Rohit1050/SoC-Memory-MBIST-RISCV/doc/01_design_decisions_and_ip_specs.md

# Design Decisions and IP Specifications
## RISC-V SoC — MBIST / ECC Monitor Platform

---

## 1. Overview

This document records the architectural decisions made during RTL specification and
the IP-level register maps, parameter choices, and interface conventions that are
frozen for this project.  It is the authoritative source of truth for integration;
if it conflicts with any other document (including older PDF revisions), this file
takes precedence.

---

## 2. Global Memory Map

| Base Address | Size  | Block | Interface |
|---|---|---|---|
| `0x0004_0000` | 128 KB | ICCM | DMA Slave Port  |
| `0x0008_0000` | 128 KB | DCCM (SECDED ECC) | DMA Slave Port  |
| `0x4000_0000` | 4 KB  | **UART** | AXI4-Lite |
| `0x4000_1000` | 4 KB  | System Timer | AXI4-Lite |
| `0x4000_2000` | 4 KB  | GPIO | AXI4-Lite |
| `0x4000_3000` | 4 KB  | MBIST Controller (CSR slave) | AXI4-Lite |
| `0x4000_4000` | 4 KB  | ECC Monitor | AXI4-Lite |
| `0x4000_5000` | 4 KB  | Watchdog Timer | AXI4-Lite |

All peripherals at `0x4000_xxxx` are reached through the `axi_interconnect_wrap_4x7`
crossbar's master ports `m01`–`m06`, each via a shared AXI4-to-AXI4-Lite bridge.
The crossbar itself operates at `DATA_WIDTH=64`, `ADDR_WIDTH=32`, `ID_WIDTH=4`.
The bridge performs 64→32 data-width conversion; peripherals are 32-bit.

---

## 3. Peripheral IP Specifications

### 3.1 AXI4 Crossbar Parameters (frozen)

| Parameter | Value | Notes |
|---|---|---|
| `DATA_WIDTH` | 64 | Master-side (core IFU/LSU/Debug/MBIST) |
| `ADDR_WIDTH` | 32 | All address channels |
| `ID_WIDTH` | 4 | Applied to all slave and master ports |
| `M_REGIONS`  | 1 | Single address region per master port |

### 3.2 AXI4-Lite Peripheral Interface Convention (all IPs at `0x4000_xxxx`)

All AXI4-Lite peripherals in this project share the same port conventions,
derived from the crossbar's Lite-side port after the bridge:

| Parameter | Value | Notes |
|---|---|---|
| `DATA_WIDTH` | 32 | Bridge handles 64→32 conversion |
| `ADDR_WIDTH` | 32 | Full address bus retained through bridge |
| `ID_WIDTH` | 4 | Bridge propagates ID unchanged |

Port naming prefix: `axi_aw*`, `axi_w*`, `axi_b*`, `axi_ar*`, `axi_r*` with
`_i` / `_o` suffixes on inputs and outputs respectively.

---

### 3.3 UART — `axil_uart_top`

**File:** `rtl/UART/axil_uart_top.v`  
**Defines:** `rtl/UART/axil_uart_defines.vh`  
**Base address:** `0x4000_0000`  
**Window:** 4 KB (`0x4000_0000` – `0x4000_0FFF`)  
**Interface:** AXI4-Lite (`DATA_WIDTH=32`, `ADDR_WIDTH=32`, `ID_WIDTH=4`)

#### 3.3.1 Parameters

| Parameter | Define | Value | Frozen? |
|---|---|---|---|
| AXI data width | `_AXI_UART_DATA_WIDTH_` | 32 | ✓ |
| AXI address width | `_AXI_UART_ADDR_WIDTH_` | 32 | ✓ |
| AXI ID width | `_AXI_UART_ID_WIDTH_` | 4 | ✓ |
| Baud-rate div width | `_AXI_UART_DIV_WIDTH_` | 16 | ✓ |
| RX / TX FIFO depth | `_AXI_UART_FIFO_DEPTH_` | 16 | — |
| Default baud divisor | `_UART_BAUDRATE_DIV_INIT_` | 434 | — (115 200 bps @ 50 MHz) |
| UART data width | `_DATA_WIDTH_UART_` | 8 | ✓ |

Note: AXI4 burst parameters (`LEN_WIDTH`, `SIZE_WIDTH`, `BURST_WIDTH`,
`LOCK_WIDTH`, `CACHE_WIDTH`, `PROT_WIDTH`, `QOS_WIDTH`, `REGION_WIDTH`)
are **absent** from `axil_uart_defines.vh`.  AXI4-Lite has no burst channels.

#### 3.3.2 Register Map

All offsets are relative to the base address `0x4000_0000`.  All registers
are 32-bit wide; only the defined bits carry meaning.

| Offset  | Word idx | Register | Access | Reset  | Description |
|---|---|---|---|---|---|
| `0x000` | `5'h00`  | RBR | R | — | Receive Buffer Register.  Reads oldest RX FIFO byte.  Valid when LSR[0]=1.  If DLAB=1, reads BAUD_DIVISOR[15:0] instead. |
| `0x000` | `5'h00`  | THR | W | — | Transmit Holding Register.  Writes byte to TX FIFO.  Ignored if TX FIFO full or DLAB=1. |
| `0x004` | `5'h01`  | IER | R/W | 0x0 | Interrupt Enable Register.  IER[0]: RX data-ready interrupt enable. |
| `0x008` | `5'h02`  | BAUD_DIVISOR | R/W | 434 | Baud-rate Divisor (16-bit).  New value takes effect immediately on write.  No DLAB guard on this register's own address. |
| `0x00C` | `5'h03`  | LCR | R/W | 0x0 | Line Control Register.  See bit map below. |
| `0x010` | `5'h04`  | *(reserved)* | — | — | No register.  Reads return 0x0 with SLVERR. |
| `0x014` | `5'h05`  | LSR | R | — | Line Status Register (read-only, combinatorial).  See bit map below. |
| `0x018`+| — | *(undefined)*| — | — | All other offsets within the 4 KB window return SLVERR. |

**All offsets resolve to addresses in the range `0x4000_0000`–`0x4000_0FFF` and
are 4-byte aligned. ✓**

#### 3.3.3 LCR Bit Map (offset `0x00C`)

| Bit | Name | Reset | Description |
|-----|---|---|---|
| 0 | `STOP_BITS` | 0 | 0 = 1 stop bit; 1 = 2 stop bits |
| 1 | `PARITY_EN` | 0 | 0 = no parity; 1 = parity enabled |
| 2 | `PARITY_MODE` | 0 | 0 = odd parity; 1 = even parity |
| 6:3 | *(reserved)*  | 0 | Reads as 0; writes ignored |
| 7 | `DLAB` | 0 | Divisor Latch Access Bit.  When DLAB=1:  `0x000` R → BAUD_DIVISOR read; `0x000` W → ignored; `0x004` R/W → reserved (reads 0). |
| 31:8| *(reserved)*  | 0 | — |

#### 3.3.4 LSR Bit Map (offset `0x014`)

| Bit | Name | Description |
|-----|---|---|
| 0 | `DR` | Data Ready: 1 when RX FIFO is non-empty AND IER[0]=1 |
| 4:1 | *(reserved)*  | Always 0 |
| 5 | `THRE` | TX Holding Register Empty: 1 when TX FIFO has space  |
| 6 | `TEMT` | TX Empty: 1 when TX FIFO and TX shift register empty |
| 31:7| *(reserved)*  | Always 0 |

#### 3.3.5 Clock Domain Notes

The module has two clock inputs:

- **`fixed_clk_i`** — UART baud-clock domain.  All sequential logic, including the
  AXI4-Lite channel handshake registers, is clocked on this domain.  Must be
  ≥ 16× the desired baud rate.

- **`axi_aclk_i`** — AXI bus clock.  Present for port compatibility with the bridge
  interface.  Currently **unused internally** — the bridge-facing AXI channel
  signals are sampled directly on `fixed_clk_i`.

  **⚠ CDC hazard:** If `fixed_clk_i ≠ axi_aclk_i` the AXI input signals cross
  clock domains without synchronizers inside this module.  A future CDC pass must
  add two-flop synchronizers before deploying to an asynchronous multi-clock
  system.  The current design is correct only when the two clocks are the same
  or phase-locked.

#### 3.3.6 FIFO Behaviour

- **TX FIFO** (depth 16): firmware writes to THR; `uart_controller` drains it.
  Writes to THR when the TX FIFO is full are silently dropped.
- **RX FIFO** (depth 16): `uart_controller` pushes received bytes; reads of RBR
  pop the oldest byte.  The `DR` bit in LSR reflects non-empty status gated by
  `IER[0]`.  If the FIFO overflows, the oldest unread byte is overwritten (no
  overflow interrupt in this revision).

#### 3.3.7 Decision: 16550-style map vs. 4-register placeholder

The `axi4_uart_top.v` baseline carried a 16550-compatible register map
(RBR/THR, IER, BAUD_DIVISOR, LCR, LSR).  An earlier design-document draft
contained a simpler 4-register placeholder.  **Decision: the 16550-style map
is adopted as the project's frozen UART register map** because:

1. It is already implemented by the UART datapath sub-modules
   (`uart_controller`, `uart_transmitter`, `uart_receiver`).
2. It provides interrupt enable, configurable parity/stop-bits, and baud-rate
   control — all required by the firmware self-test loop.
3. The DLAB mechanism allows baud-rate divisor access without consuming an
   additional register offset.

The simpler placeholder is superseded by this table.

---

### 3.4 Watchdog Timer — `axil_wdt_top`

**File:** `rtl/watchdog_timer/axil_wdt_top.v`  
**Base address:** `0x4000_5000`  
**Window:** 4 KB (`0x4000_5000` – `0x4000_5FFF`)  
**Crossbar port:** `m06` on `axi_interconnect_wrap_4x7` (via AXI4-to-AXI4-Lite bridge)  
**Interface:** AXI4-Lite (`DATA_WIDTH=32`, `ADDR_WIDTH=32`, `ID_WIDTH=4`)  

#### 3.4.1 Register Map

All offsets are relative to base address `0x4000_5000`. All registers are 32-bit aligned.

| Offset  | Word idx | Register | Access | Reset | Description |
|---|---|---|---|---|---|
| `0x000` | `4'h0` | `wdg_enable` | R/W | 0x0 | Master enable. Bit 0 enables the countdown. |
| `0x004` | `4'h1` | `wdg_load` | R/W | 0x0 | Timeout and reload value in clock cycles. |
| `0x008` | `4'h2` | `wdg_kick` | W | — | Pet watchdog. Writing any value reloads `wdg_count` with `wdg_load`. Reads return 0. |
| `0x00C` | `4'h3` | `wdg_count` | RO | 0x0 | Current countdown value (diagnostic read). Writes return SLVERR. |
| `0x010` | `4'h4` | `wdg_status` | R/W1C  | 0x0 | Bit 0: `timeout_occurred` — latched across warm reset; write 1 to clear. |
| `0x014` | `4'h5` | `wdg_pretimeout`  | R/W | 0x0 | Early-warning threshold; asserts `wdg_irq_pretimeout` when count <= val. |
| `0x018`+| — | *(undefined)* | — | — | All other offsets within the 4 KB window return SLVERR. |

#### 3.4.2 Non-Bus Signals

| Signal | Direction | Width | Destination | Description |
|---|---|---|---|---|
| `wdg_timeout_o` | Output | 1 | External Reset Logic  | Asserted on countdown expiry; drives system reset via `rst_l`. |
| `wdg_irq_pretimeout_o` | Output | 1 | PIC (`extintsrc_req`) | Early-warning interrupt prior to timeout expiry. |
| `timeout_occurred_o` | Output | 1 | Debug / Diagnostics | Direct status tap of `timeout_occurred` flag. |

#### 3.4.3 Reset and Post-Mortem Architecture

The Watchdog Timer uses a dual-reset architecture:
- **`por_rstn_i`** (Power-On Reset / Cold Reset): Resets the sticky `timeout_occurred` status bit to 0.
- **`axi_aresetn_i`** (System / Warm Reset): Resets the FSMs, `wdg_enable`, `wdg_load`, and `wdg_count`. The `timeout_occurred` flag is intentionally preserved across `axi_aresetn_i` assertions. When `wdg_timeout_o` triggers external reset logic, the core reboots, firmware reads `wdg_status[0] == 1`, identifies a watchdog recovery event, and writes 1 to clear the status bit (W1C).

---

### 3.5 ECC Monitor — `axil_ecc_monitor_top`

**File:** `rtl/ecc_monitor/axil_ecc_monitor_top.v`  
**Base address:** `0x4000_4000`  
**Window:** 4 KB (`0x4000_4000` – `0x4000_4FFF`)  
**Crossbar port:** `m05` on `axi_interconnect_wrap_4x7` (via AXI4-to-AXI4-Lite bridge)  
**Interface:** AXI4-Lite (`DATA_WIDTH=32`, `ADDR_WIDTH=32`, `ID_WIDTH=4`)  

#### 3.5.1 Register Map

| Offset  | Word idx | Register | Access | Reset | Description |
|---|---|---|---|---|---|
| `0x000` | `3'h0` | `ecc_mon_enable` | R/W | 0x0 | Master enable bit. |
| `0x004` | `3'h1` | `ecc_mon_shadow_count`  | R/W | 0x0 | 27-bit firmware mirror of core CSR `mdccmect.count`. |
| `0x008` | `3'h2` | `ecc_mon_shadow_thresh` | R/W | 0x0 | 5-bit firmware mirror of core CSR `mdccmect.thresh`. |
| `0x00C` | `3'h3` | `ecc_mon_event` | W1C | 0x0 | FW writes 1 to signal correctable ISR fired; triggers correlation. |
| `0x010` | `3'h4` | `ecc_mon_suspect_addr`  | RO | 0x0 | MBIST window active at last correlated event. |
| `0x014` | `3'h5` | `ecc_mon_status` | RO | 0x0 | Bit 0: `correctable_seen`; Bit 1: `mbist_correlated`. |
| `0x018`+| — | *(undefined)* | — | — | All other offsets in 4 KB window return SLVERR. |

---

### 3.6 MBIST Controller — `axil_mbist_ctrl_top`

**Files:** `rtl/mbist_controller/axil_mbist_ctrl_top.v`, `mbist_algo_engine.v`, `mbist_dma_master.v`, `axil_mbist_defines.vh`  
**Base address:** `0x4000_3000`  
**Window:** 4 KB (`0x4000_3000` – `0x4000_3FFF`)  
**Crossbar ports:** Slave CSR `m04` (AXI4-Lite via bridge); Master DMA port `s03` (64-bit full AXI4 to DCCM)  
**Interface:** Dual-personality: 32-bit AXI4-Lite slave + 64-bit AXI4 master  

#### 3.6.1 Register Map

| Offset  | Word idx | Register | Access | Reset | Description |
|---|---|---|---|---|---|
| `0x000` | `4'h0` | `mbist_start` | W | — | Write 1 to launch self-test scan (auto-clears). |
| `0x004` | `4'h1` | `mbist_algo_sel` | R/W | `2'b01` | 00 = Checkerboard, 01 = March C-. |
| `0x008` | `4'h2` | `mbist_addr_start`  | R/W | `0x00080000` | Start address of DCCM test region (64-bit aligned). |
| `0x00C` | `4'h3` | `mbist_addr_end` | R/W | `0x0009FFF8` | End address of DCCM test region (64-bit aligned). |
| `0x010` | `4'h4` | `mbist_busy` | RO | 0x0 | Asserted while self-test is actively executing. |
| `0x014` | `4'h5` | `mbist_done` | RO/W1C | 0x0 | Asserted on scan completion; cleared on new start or writing 1. |
| `0x018` | `4'h6` | `mbist_pass_fail` | RO | 0x0 | 0 = PASS, 1 = Directly-detected fault present (SLVERR or data mismatch).|
| `0x01C` | `4'h7` | `mbist_fault_addr`  | RO | 0x0 | Address of the first directly-detected fault. |
| `0x020` | `4'h8` | `mbist_fault_count` | RO | 0x0 | 16-bit count of directly-detected faults. |
| `0x024`+| — | *(undefined)* | — | — | All other offsets in 4 KB window return SLVERR. |

#### 3.6.2 Sideband Signals

| Signal | Direction | Width | Destination | Description |
|---|---|---|---|---|
| `mbist_active_o` | Output | 1 | ECC Monitor, WDT | Asserted during active scan for ECC correlation. |
| `mbist_fault_addr_tap_o` | Output | 32 | ECC Monitor | Real-time test window tap latched upon correctable error.|
| `mbist_irq_done_o` | Output | 1 | PIC (`extintsrc_req`)  | 1-cycle interrupt pulse on scan completion. |
| `timer_tick_i` | Input | 1 | System Timer | External auto-trigger pulse to start scan. |

---

## 4. Verification Notes

- **UART:** `tb/uart/tb_axil_uart_top.v` (10 test cases)
- **ECC Monitor:** `tb/ecc_monitor/tb_axil_ecc_monitor_top.v` (15 test cases)
- **Watchdog Timer:** `tb/watchdog_timer/tb_axil_wdt_top.v` (12 test cases)
- **MBIST Controller:** `tb/mbist_controller/tb_axil_mbist_ctrl_top.v` (9 test cases)
- Shared AXI4-Lite BFM master: `tb/common/axil_bfm_master.v`

---

*Document revision: 1.2 — 2026-10-02*
