Rohit1050/SoC-Memory-MBIST-RISCV/rtl/interconnect/soc_register_map_across_crossbar.png

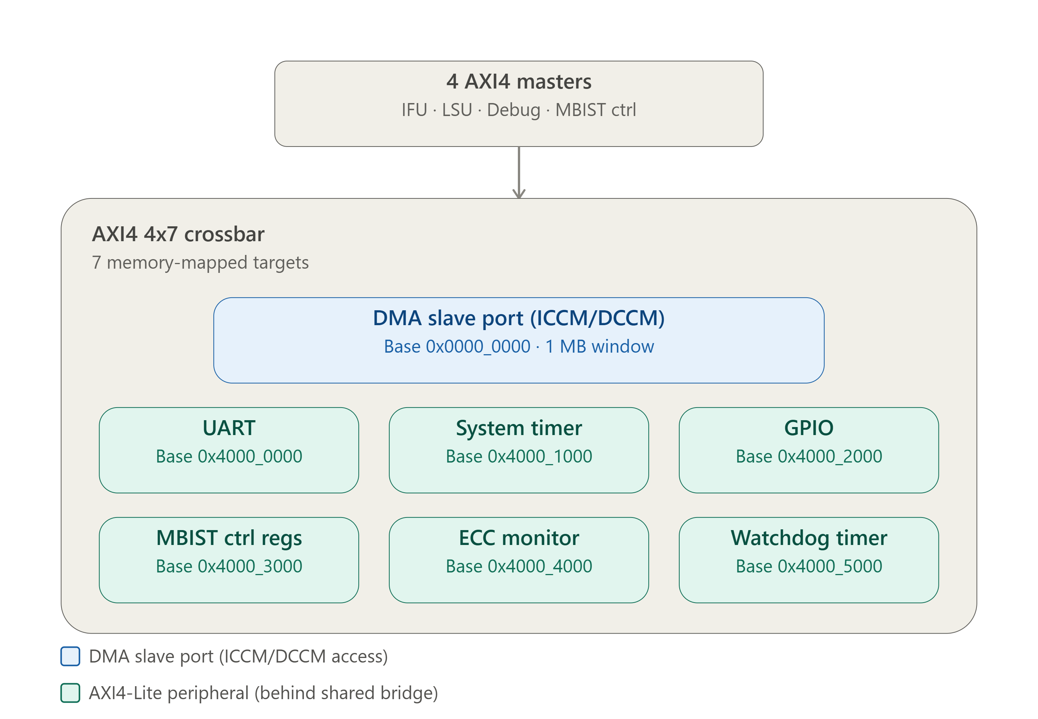
rtl/interconnect/soc_register_map_across_crossbar.png
