Rohit1050/SoC-Memory-MBIST-RISCV/doc/testmap_soc_readable.xlsx

Sheet: Testmap_SoC_Categorized
S.No | Test Name | Test Scope | Description | C Portion (firmware/test/) | SV Portion (tb/) | Interface
1 | BOOT_RESET_VECTOR | External to SoC | Core fetches first instruction from ICCM base 0x0004_0000 after reset release — confirms rst_vec wiring in soc_core_integration.sv | Not applicable | tb_soc_top.sv — TC01: monitor no ECC double-error and no UART FAIL within 500 cycles after reset release
2 | BOOT_ICCM_LOAD | External to SoC | Firmware loaded into ICCM via $readmemh before reset release; core executes correct code from cycle 1 | Not applicable | tb_soc_top.sv — runtime $readmemh into u_iccm.flat_image + ECC recompute in reset initial block
3 | BOOT_STACK_INIT | Internal to SoC | crt0.s sets SP to DCCM top (0x0008_4000); .data copied from ICCM LMA to DCCM VMA; .bss zeroed before main() | Implicit in every test — if stack is wrong all tests fail | iccm_behavioral_model.v — verifies flat_image bank interleave and ECC matches
4 | BOOT_NO_SPURIOUS_ECC | External to SoC | No ECC single or double errors asserted in first 500 cycles on a freshly-loaded clean ICCM/DCCM | Not applicable | tb_soc_top.sv — monitor dccm_ecc_single_error / dccm_ecc_double_error / iccm_ecc_single_error / iccm_ecc_double_error
5 | XBAR_ADDR_DECODE_UART | Internal to SoC | LSU write to 0x4000_0000 routes to m01 (UART) with OKAY response — confirms crossbar address decode | test_uart.c — any UART_THR write exercises this path | tb_soc_top.sv — monitor m01_axi_awvalid + m01_axi_awaddr == 0x4000_0000
6 | XBAR_ADDR_DECODE_TIMER | Internal to SoC | LSU access to 0x4000_1000 routes to m02 (System Timer) | test_timer.c — TMR_EN write | tb_soc_top.sv — monitor m02_axi_awvalid + m02_axi_awaddr == 0x4000_1000
7 | XBAR_ADDR_DECODE_GPIO | Internal to SoC | LSU access to 0x4000_2000 routes to m03 (GPIO) | test_gpio.c — GPIO_DIR write | tb_soc_top.sv — TC02: monitor m03_axi_arvalid handshake
8 | XBAR_ADDR_DECODE_MBIST | Internal to SoC | LSU access to 0x4000_3000 routes to m04 (MBIST CSR) | test_mbist.c — MBIST_START write | tb_soc_top.sv — monitor m04_axi_awaddr == 0x4000_3000
9 | XBAR_ADDR_DECODE_ECC | Internal to SoC | LSU access to 0x4000_4000 routes to m05 (ECC Monitor) | test_ecc.c — ECC_ENABLE write | tb_soc_top.sv — monitor m05_axi_awvalid
10 | XBAR_ADDR_DECODE_WDT | Internal to SoC | LSU access to 0x4000_5000 routes to m06 (WDT) | test_watchdog.c — WDG_ENABLE write | tb_soc_top.sv — monitor m06_axi_awvalid
11 | XBAR_DECERR_UNMAPPED | Internal to SoC | LSU access to unmapped address (e.g. 0xDEAD_0000) returns DECERR from crossbar — core must survive | Implicit — firmware accesses unmapped offset in SLVERR subtests | tb_soc_top.sv — TC02: monitor any mXX_rresp == 2b11 (DECERR)
12 | XBAR_64TO32_BRIDGE | Internal to SoC | AXI4 64-bit LSU write correctly downconverted to 32-bit by axi4_to_axil_bridge before reaching peripheral register | test_gpio.c — GPIO_OUT = 0xA5 (32-bit value visible on 64-bit bus) | tb_axil_gpio_top.v — verify wdata[31:0] matches written value after bridge
13 | XBAR_CONCURRENT_MASTERS | Internal to SoC | IFU fetch (m00/ICCM) and LSU peripheral write (m01-m06) occur simultaneously without arbitration deadlock | Any firmware test — IFU always active while LSU writes | tb_soc_top.sv — monitor ifu_axi_arvalid and lsu_axi_awvalid high in same cycle
14 | UART_RESET_STATE | Internal to SoC | LSR[5] THRE=1 and LSR[6] TEMT=1 at cold boot (TX FIFO and shift register empty) | test_uart.c — Subtest 1: read LSR at boot | tb_axil_uart_top.v — check LSR reset value
15 | UART_LCR_8N1 | Internal to SoC | LCR=0x03 programs 8 data bits / no parity / 1 stop bit; readback matches | test_uart.c — Subtest 2: write 0x03 read back | tb_axil_uart_top.v — verify LCR register stores value
16 | UART_LCR_PARITY | External to SoC | LCR parity bits (odd/even) write and readback correctly | test_uart.c — Subtest 2: 0x0B (8O1) / 0x1B (8E1) | tb_axil_uart_top.v — verify parity encoding on TX serial output | UART serial
17 | UART_BAUD_DLAB | Internal to SoC | LCR[7]=1 enables DLAB; BAUD_DIV register write/readback at 0x4000_0008 | test_uart.c — Subtest 3: LCR=0x83 then write/read UART_BDIV | tb_axil_uart_top.v — verify baud divisor register path
18 | UART_TX_THRE_POLL | External to SoC | Firmware writes THR only when LSR[5]=1 (THRE); no data loss under polling | test_uart.c — Subtest 5: send A-Z with explicit THRE poll | tb_axil_uart_top.v — verify each byte appears on uart_tx_o serial output | UART serial
19 | UART_TX_FIFO_DEPTH | Internal to SoC | TX FIFO holds 16 entries; firmware can burst 16 bytes without THRE stalling | test_uart.c — Subtest 6: three-line burst | tb_axil_uart_top.v — verify no byte dropped during burst
20 | UART_TEMT_DRAIN | External to SoC | LSR[6] TEMT asserts only after both TX FIFO and TX shift register drain | test_uart.c — Subtest 7: wait_temt() after burst | tb_axil_uart_top.v — monitor TEMT high after last serial bit | UART serial
21 | UART_IER_RW | Internal to SoC | IER bits 0 and 1 write/readback independently; clear to 0 disables all interrupts | test_uart.c — Subtest 4: IER=0x01 / 0x02 / 0x03 / 0x00 | tb_axil_uart_top.v — verify IER register behaviour
22 | UART_SLVERR_UNMAPPED | Internal to SoC | Read from UART+0x010 (reserved offset) returns SLVERR; CPU continues executing | test_uart.c — Subtest 8: read from UART_BASE+0x010 | tb_axil_uart_top.v — verify SLVERR response on unmapped offset
23 | GPIO_RESET_STATE | Internal to SoC | GPIO_DIR=0x00 (all inputs) and GPIO_OUT=0x00 after reset | test_gpio.c — Subtest 1: read DIR and OUT at boot | tb_axil_gpio_top.v — verify reset values of both registers
24 | GPIO_DIR_WALKING_ONES | External to SoC | Each individual GPIO_DIR bit can be set to 1 independently (8 iterations) | test_gpio.c — Subtest 2: walking-ones loop | tb_axil_gpio_top.v — verify gpio_out_o gating per bit | GPIO output
25 | GPIO_DIR_WALKING_ZEROS | External to SoC | Each individual GPIO_DIR bit can be cleared to 0 independently | test_gpio.c — Subtest 2: walking-zeros loop | tb_axil_gpio_top.v — verify gpio_out_o gating per bit | GPIO output
26 | GPIO_OUT_CHECKERBOARD | External to SoC | GPIO_OUT=0xA5 and GPIO_OUT=0x5A write/readback correctly | test_gpio.c — Subtest 3: 0xA5 / 0x5A patterns | tb_axil_gpio_top.v — verify gpio_out_o == DIR & OUT | GPIO output
27 | GPIO_OUT_DIR_INDEPENDENCE | Internal to SoC | GPIO_OUT retains value across GPIO_DIR changes (DIR does not corrupt OUT register) | test_gpio.c — Subtest 4: set OUT=0xC3 then flip DIR multiple times | tb_axil_gpio_top.v — verify gpio_out_o changes but OUT register constant
28 | GPIO_IN_READONLY | Internal to SoC | Writes to GPIO_IN offset are silently ignored; register value unchanged | test_gpio.c — Subtest 5: write ~before to GPIO_IN; readback unchanged | tb_axil_gpio_top.v — force gpio_in_i; verify write to 0x008 has no effect
29 | GPIO_OUTPUT_GATING | External to SoC | gpio_out_o[i] = gpio_dir[i] AND gpio_out_reg[i] — hardware gating verified | test_gpio.c — Subtest 6: DIR=0x0F OUT=0xFF; expected gpio_out_o=0x0F | tb_axil_gpio_top.v — check gpio_out_o against expected mask | GPIO output
30 | GPIO_INPUT_SYNC | External to SoC | gpio_in_i external value appears in GPIO_IN after 2-flop synchronisation | Not applicable (requires TB to drive gpio_in_i) | tb_axil_gpio_top.v — force gpio_in_i; read GPIO_IN after 2 clock edges | GPIO input
31 | GPIO_SLVERR_UNMAPPED | Internal to SoC | Read from GPIO+0x00C (unmapped) returns SLVERR; CPU survives | test_gpio.c — Subtest 7: read from GPIO_BASE+0x00C | tb_axil_gpio_top.v — verify SLVERR on unmapped GPIO offset
32 | TIMER_RESET_STATE | Internal to SoC | TMR_EN=0 / TMR_RELOAD=0 / TMR_COUNT=0 at cold boot | test_timer.c — Subtest 1: read all three registers at boot | tb_axil_systimer_top.v — verify reset values
33 | TIMER_RELOAD_RW | Internal to SoC | TMR_RELOAD accepts full 32-bit values including 0xDEADBEEF and 0xFFFFFFFF | test_timer.c — Subtest 2: multiple reload values | tb_axil_systimer_top.v — verify register storage
34 | TIMER_COUNTDOWN | Internal to SoC | TMR_COUNT decrements every clock cycle while TMR_EN=1; two reads show strictly decreasing value | test_timer.c — Subtest 3: c1 then delay then c2; assert c2 < c1 | tb_axil_systimer_top.v — monitor timer_count decrement
35 | TIMER_HOLD_ON_DISABLE | Internal to SoC | TMR_COUNT freezes (holds) when TMR_EN=0; re-enable resumes from frozen value | test_timer.c — Subtest 4: read h1/h2 while disabled; assert h1==h2 | tb_axil_systimer_top.v — verify count stops on disable
36 | TIMER_REARM | Internal to SoC | Disable then write TMR_RELOAD then re-enable: count preloads to TMR_RELOAD value (not frozen value) | test_timer.c — Subtest 5: partially drain; re-arm with new_reload; verify count==new_reload | tb_axil_systimer_top.v — verify re-arm preloads reload value
37 | TIMER_COUNT_READONLY | Internal to SoC | Writes to TMR_COUNT (0x008) are silently accepted (OKAY) but counter is unaffected | test_timer.c — Subtest 6: write 0xDEADBEEF to TMR_COUNT; readback unchanged | tb_axil_systimer_top.v — verify write to RO register has no effect
38 | TIMER_TICK_PULSE | Internal to SoC | timer_tick_o pulses HIGH for exactly 1 clock cycle on countdown expiry; counter auto-reloads | Not applicable (requires cycle-accurate measurement) | tb_axil_systimer_top.v — monitor timer_tick_o width == 1 cycle
39 | TIMER_TICK_MBIST_TRIGGER | Internal to SoC | timer_tick_o connected to MBIST Controller timer_tick_i; MBIST auto-starts on tick | Not applicable (SoC-level wiring) | tb_soc_top.sv — TC07: pulse timer_tick; verify mbist_active asserts within 20 cycles
40 | TIMER_SLVERR_UNMAPPED | Internal to SoC | Read from Timer+0x00C (unmapped) returns SLVERR; CPU survives | test_timer.c — Subtest 8: read from TMR_BASE+0x00C | tb_axil_systimer_top.v — verify SLVERR response
41 | WDT_RESET_STATE | Internal to SoC | WDG_ENABLE=0 at cold boot; WDT not running; no spurious timeout | test_watchdog.c — Subtest 1: read WDG_ENABLE at boot | tb_axil_wdt_top.v — verify no wdg_timeout_o pulse at reset
42 | WDT_LOAD_RW | Internal to SoC | WDG_LOAD accepts full 32-bit values including boundary cases | test_watchdog.c — Subtest 2: multiple load values | tb_axil_wdt_top.v — verify register storage
43 | WDT_COUNTDOWN | Internal to SoC | WDG_COUNT decrements each clock cycle while WDG_ENABLE=1 | test_watchdog.c — Subtest 3: enable; read c1/c2; assert c2 < c1 | tb_axil_wdt_top.v — monitor wdg_count decrement
44 | WDT_KICK_RELOADS | Internal to SoC | Writing WDG_KICK reloads WDG_COUNT to WDG_LOAD instantly | test_watchdog.c — Subtest 4: enable; drain; kick; assert count==WDG_LOAD | tb_axil_wdt_top.v — verify count restores to load value on kick
45 | WDT_HOLD_ON_DISABLE | Internal to SoC | WDG_COUNT holds at current value when WDG_ENABLE=0 (does NOT reset to load) | test_watchdog.c — Subtest 5: disable; read h1/h2; assert h1==h2 and h1!=WDG_LOAD | tb_axil_wdt_top.v — verify count freezes on disable
46 | WDT_STATUS_W1C | Internal to SoC | WDG_STATUS[0] timeout_occurred cleared by writing 1; writing 0 has no effect | test_watchdog.c — Subtest 6: write 1 clears; write 0 leaves unchanged | tb_axil_wdt_top.v — verify W1C behaviour
47 | WDT_STATUS_STICKY | External to SoC | timeout_occurred survives warm system reset (axi_aresetn) but clears on POR (por_rstn) | Not applicable (warm reset kills firmware) | tb_axil_wdt_top.v — assert axi_aresetn; verify status bit survives; assert por_rstn; verify clears
48 | WDT_PRETIMEOUT_RW | Internal to SoC | WDG_PRETIMEOUT register write/readback with threshold < WDG_LOAD | test_watchdog.c — Subtest 7: multiple pretimeout values | tb_axil_wdt_top.v — verify pretimeout_irq_o asserts when count <= threshold
49 | WDT_PRETIMEOUT_IRQ | Internal to SoC | pretimeout_irq_o asserts when WDG_COUNT falls below WDG_PRETIMEOUT threshold | Not applicable (interrupt timing requires cycle precision) | tb_axil_wdt_top.v — count down to threshold; verify pretimeout_irq_o rises
50 | WDT_TIMEOUT_RESET | External to SoC | WDG_COUNT reaching 0 asserts wdg_timeout_o which drives system reset | Not applicable (timeout kills firmware) | tb_axil_wdt_top.v — load small value; enable; count to 0; verify wdg_timeout_o pulse
51 | WDT_NO_TIMEOUT_DURING_TEST | Internal to SoC | WDG_STATUS[0] remains 0 throughout all subtests (no accidental expiry) | test_watchdog.c — Subtest 8: final status check | tb_soc_top.sv — verify no wdg_timeout_o assertion during full test
52 | WDT_PRETIMEOUT_PIC_ROUTING | Internal to SoC | wdg_irq_pretimeout_o routed to PIC extintsrc_req[2]; no bus errors after IRQ | Not applicable | tb_soc_top.sv — TC06: pulse wdg_irq_pretimeout; verify no double-ECC error
53 | MBIST_CSR_READBACK | Internal to SoC | All CSR registers (ALGO_SEL / ADDR_START / ADDR_END) write and readback correctly before scan | test_mbist.c — Subtest 1: write/read each register | tb_axil_mbist_ctrl_top.v — verify all 9 register values via BFM
54 | MBIST_BUSY_DONE_HANDSHAKE | Internal to SoC | mbist_busy asserts immediately after MBIST_START write; mbist_done asserts on completion | test_mbist.c — Subtest 2: read busy after start; poll done | tb_axil_mbist_ctrl_top.v — verify busy/done timing in waveform
55 | MBIST_DONE_W1C | Internal to SoC | mbist_done cleared by writing 1 (W1C); stays asserted if write 0 | test_mbist.c — Subtest 3: write 1 to MBIST_DONE; verify cleared | tb_axil_mbist_ctrl_top.v — verify W1C behaviour
56 | MBIST_CHECKERBOARD_SMALL | Internal to SoC | Checkerboard algorithm on 128-byte DCCM window completes with PASS (pass_fail=0) | test_mbist.c — Subtest 2: ALGO=CB MB_START to MB_SM_END | tb_axil_mbist_ctrl_top.v — inject no fault; verify pass_fail==0
57 | MBIST_MARCH_C_SMALL | Internal to SoC | March C- algorithm on 128-byte window completes with PASS | test_mbist.c — Subtest 4: ALGO=MC MB_START to MB_SM_END | tb_axil_mbist_ctrl_top.v — verify pass_fail==0 and fault_count==0
58 | MBIST_MARCH_C_FULL | Internal to SoC | March C- over full safe DCCM scan window (MB_START to MB_END = 8 KB) completes with PASS | test_mbist.c — Subtest 5: ALGO=MC MB_START to MB_END | tb_axil_mbist_ctrl_top.v — full range scan; verify pass_fail==0
59 | MBIST_FAULT_DOUBLE_BIT | External to SoC | Double-bit DCCM fault causes SLVERR on DMA read; pass_fail=1; fault_addr captured | Not applicable (fault injection is TB-side) | tb_axil_mbist_ctrl_top.v + tb_soc_top.sv TC04 — inject double-bit; verify pass_fail==1 and fault_count>0
60 | MBIST_FAULT_ADDR_CAPTURE | External to SoC | mbist_fault_addr holds address of first fault; mbist_fault_count increments per fault | Not applicable | tb_axil_mbist_ctrl_top.v — inject fault at known address; verify fault_addr matches
61 | MBIST_DMA_AXI4_MASTER | Internal to SoC | MBIST DMA master issues correct 64-bit AXI4 transactions to DCCM DMA Slave Port | Not applicable | tb_axil_mbist_ctrl_top.v — monitor AXI4 DMA master signals during scan
62 | MBIST_TIMER_AUTOTRIGGER | Internal to SoC | timer_tick_i input starts MBIST scan without firmware MBIST_START write | Not applicable | tb_soc_top.sv — TC07: pulse timer_tick; mbist_active within 20 cycles
63 | MBIST_ACTIVE_SIDEBAND | Internal to SoC | mbist_active_o asserts during scan and deasserts on completion | Not applicable | tb_soc_top.sv — monitor mbist_active rising/falling edge around scan
64 | MBIST_IRQ_DONE | Internal to SoC | mbist_irq_done_o pulses 1 cycle on scan completion; routed to PIC extintsrc_req[1] | Not applicable | tb_soc_top.sv — TC03: monitor mbist_irq_done after scan completes
65 | MBIST_SCAN_WINDOW | Internal to SoC | Only addresses between mbist_addr_start and mbist_addr_end are accessed — nothing outside | Not applicable | tb_axil_mbist_ctrl_top.v — monitor DMA AXI araddr stays within configured window
66 | ECC_MON_SHADOW_RW | Internal to SoC | ecc_mon_shadow_count (27-bit) and ecc_mon_shadow_thresh (5-bit) write/readback correctly | test_ecc.c — Subtest 1: write 0x1234 / 5 to shadow regs | tb_axil_ecc_monitor_top.v — verify register storage and bit-width masking
67 | ECC_MON_DISABLED_SUPPRESSION | Internal to SoC | ecc_mon_event write ignored when ecc_mon_enable=0; status unchanged | test_ecc.c — Subtest 2: disable monitor; fire event; verify status==0 | tb_axil_ecc_monitor_top.v — verify no status change when disabled
68 | ECC_MON_CORRECTABLE_SEEN | Internal to SoC | correctable_seen flag (status[0]) sets when ecc_mon_event written with monitor enabled | test_ecc.c — Subtest 3: enable; write event; verify status[0]==1 | tb_axil_ecc_monitor_top.v — verify status bit assertion
69 | ECC_MON_IDLE_NOT_CORRELATED | Internal to SoC | mbist_correlated flag (status[1]) stays 0 when event fires but no MBIST scan is active | test_ecc.c — Subtest 3: verify status[1]==0 with no scan active | tb_axil_ecc_monitor_top.v — verify no false correlation
70 | ECC_MON_MBIST_CORRELATED | Internal to SoC | mbist_correlated flag (status[1]) sets when ecc_mon_event fires during active MBIST scan | test_ecc.c — Subtest 4: start scan; wait busy; fire event; verify status[1]==1 | tb_soc_top.sv — TC05: inject single-bit fault; verify dccm_ecc_single_error + correlation
71 | ECC_MON_SUSPECT_ADDR | Internal to SoC | ecc_mon_suspect_addr captures MBIST scan window address at time of correlated event | test_ecc.c — Subtest 4: verify suspect_addr inside DCCM range | tb_axil_ecc_monitor_top.v — verify suspect_addr falls within mbist window
72 | ECC_MON_EVENT_W1C | Internal to SoC | ecc_mon_event reads back 0 after write (W1C register) | test_ecc.c — Subtest 5: verify ECC_EVENT reads 0 after write | tb_axil_ecc_monitor_top.v — verify W1C behaviour
73 | ECC_DCCM_SINGLE_BIT | External to SoC | VeeR EL2 SECDED hardware corrects 1-bit DCCM error inline; dccm_ecc_single_error_o asserts; mdccmect increments | Not applicable (fault injection TB-side) | tb_soc_top.sv — TC05: inject 1-bit via u_dccm.inject_single_bit_fault; monitor dccm_ecc_single_error_o
74 | ECC_DCCM_DOUBLE_BIT | External to SoC | VeeR EL2 SECDED detects 2-bit DCCM error; RRESP=SLVERR returned; dccm_ecc_double_error_o asserts | Not applicable | tb_soc_top.sv — TC04: inject 2-bit; verify dccm_ecc_double_error_o and SLVERR
75 | ECC_ICCM_SINGLE_BIT | External to SoC | VeeR EL2 corrects 1-bit ICCM error inline; iccm_ecc_single_error_o asserts | Not applicable | tb_soc_top.sv — inject 1-bit into u_iccm; monitor iccm_ecc_single_error_o
76 | IRQ_MBIST_DONE_PIC | Internal to SoC | mbist_irq_done_o routed to extintsrc_req[1] and reaches PIC; firmware ISR executes | test_mbist.c — Requires ISR handler (future firmware) | tb_soc_top.sv — TC08: wait for UART PASS token after MBIST IRQ
77 | IRQ_WDT_PRETIMEOUT_PIC | Internal to SoC | wdg_irq_pretimeout_o routed to extintsrc_req[2] and reaches PIC; no bus faults ensue | test_watchdog.c — Requires ISR handler (future firmware) | tb_soc_top.sv — TC06: pulse pretimeout; verify no double-ECC after IRQ
78 | IRQ_PIC_PRIORITY | Internal to SoC | PIC correctly prioritises MBIST IRQ (extintsrc_req[1]) over WDT IRQ (extintsrc_req[2]) when both asserted simultaneously | Not applicable | tb_soc_top.sv — assert both simultaneously; verify higher-priority IRQ taken first
79 | DCCM_WRITE_READBACK | Internal to SoC | VeeR EL2 LSU writes a pattern to DCCM and reads it back correctly; write-readback error flag stays 0 | test_mbist.c — DCCM written by MBIST DMA; LSU reads back | tb_soc_top.sv — monitor dccm_write_readback_error_o stays 0
80 | DCCM_ECC_ENCODE_DECODE | Internal to SoC | VeeR EL2 core encodes SECDED ECC on every DCCM write and decodes on every read — no spurious errors on clean memory | Not applicable | tb_soc_top.sv + dccm_behavioral_model.v — run full scan with no faults; verify no ECC errors
81 | DCCM_MBIST_INDIRECT_SINGLE | External to SoC | Single-bit fault not detected by MBIST data mismatch (corrected inline) — inferred via mdccmect rise + ECC Monitor correlation | test_ecc.c — mdccmect shadow comparison + ECC event | tb_soc_top.sv — inject 1-bit; verify pass_fail stays 0 but dccm_ecc_single_error asserts
82 | SOC_FIRMWARE_BOOT_TO_PASS | Internal to SoC | Full firmware test (test_mbist.c) boots executes and prints ALL TESTS PASSED on UART within timeout | test_mbist.c — all 5 subtests pass; uart_print(ALL TESTS PASSED) | tb_soc_top.sv — TC08: monitor uart_pass_seen within 2M cycles
83 | SOC_CONCURRENT_IFU_LSU | Internal to SoC | IFU instruction fetch (ICCM) and LSU peripheral write (peripherals) proceed simultaneously without stall or corruption | Any firmware test — IFU always active | tb_soc_top.sv — monitor ifu_axi_arvalid and lsu_axi_awvalid simultaneously high
84 | SOC_MBIST_WHILE_CPU_RUNNING | Internal to SoC | MBIST DMA master accesses DCCM via DMA Slave Port while CPU executes from ICCM — no interference | test_mbist.c — CPU polls MBIST_DONE while MBIST scans DCCM | tb_soc_top.sv — monitor mbist_active=1 and ifu_axi_arvalid=1 simultaneously
85 | SOC_FULL_PERIPHERAL_SCAN | Internal to SoC | All 6 peripherals accessed in sequence within one firmware run; all return OKAY; no bus hangs | Covered collectively by test_mbist + test_ecc + test_uart + test_gpio + test_timer + test_watchdog | tb_soc_top.sv — run all firmware tests sequentially; no timeout on any mXX bus

Sheet: Complete_Flat_Matrix
S.No | Subsystem | Test Name | Test Scope | Verification Level | Stimulus / Exec Mode | Interface Boundary | Scope Justification | Description | C Firmware Path | SV Testbench Path
1 | Boot & System | BOOT_RESET_VECTOR | External to SoC | Full SoC Integration | External TB (Reset Pin) | External Reset Pin (rst_l) | TB drives external reset release (rst_l) and verifies cold-boot vector execution before firmware starts | Core fetches first instruction from ICCM base 0x0004_0000 after reset release — confirms rst_vec wiring in soc_core_integration.sv | Not applicable | tb_soc_top.sv — TC01: monitor no ECC double-error and no UART FAIL within 500 cycles after reset release
2 | Boot & System | BOOT_ICCM_LOAD | External to SoC | Full SoC Integration | External TB ($readmemh) | External Memory Preload | TB preloads compiled firmware binary into ICCM via $readmemh backdoor prior to reset release | Firmware loaded into ICCM via $readmemh before reset release; core executes correct code from cycle 1 | Not applicable | tb_soc_top.sv — runtime $readmemh into u_iccm.flat_image + ECC recompute in reset initial block
3 | Boot & System | BOOT_STACK_INIT | Internal to SoC | Memory Model / Full SoC | Firmware (crt0.s) | Internal Core & DCCM Stack | crt0.s startup code runs on core to initialize SP in DCCM, copy .data, and zero .bss internally | crt0.s sets SP to DCCM top (0x0008_4000); .data copied from ICCM LMA to DCCM VMA; .bss zeroed before main() | Implicit in every test — if stack is wrong all tests fail | iccm_behavioral_model.v — verifies flat_image bank interleave and ECC matches
4 | Boot & System | BOOT_NO_SPURIOUS_ECC | External to SoC | Full SoC Integration | External TB Monitor | External Core ECC Status Pins | TB monitors core ECC error output pins during first 500 cycles following reset release | No ECC single or double errors asserted in first 500 cycles on a freshly-loaded clean ICCM/DCCM | Not applicable | tb_soc_top.sv — monitor dccm_ecc_single_error / dccm_ecc_double_error / iccm_ecc_single_error / iccm_ecc_double_error
5 | Axi4 Crossbar / Interconnect | XBAR_ADDR_DECODE_UART | Internal to SoC | Full SoC Integration | Firmware (C) | Internal AXI4 Crossbar | Internal crossbar address decoder routes core LSU transaction to UART slave port | LSU write to 0x4000_0000 routes to m01 (UART) with OKAY response — confirms crossbar address decode | test_uart.c — any UART_THR write exercises this path | tb_soc_top.sv — monitor m01_axi_awvalid + m01_axi_awaddr == 0x4000_0000
6 | Axi4 Crossbar / Interconnect | XBAR_ADDR_DECODE_TIMER | Internal to SoC | Full SoC Integration | Firmware (C) | Internal AXI4 Crossbar | Internal crossbar address decoder routes core LSU transaction to TIMER slave port | LSU access to 0x4000_1000 routes to m02 (System Timer) | test_timer.c — TMR_EN write | tb_soc_top.sv — monitor m02_axi_awvalid + m02_axi_awaddr == 0x4000_1000
7 | Axi4 Crossbar / Interconnect | XBAR_ADDR_DECODE_GPIO | Internal to SoC | Full SoC Integration | Firmware (C) | Internal AXI4 Crossbar | Internal crossbar address decoder routes core LSU transaction to GPIO slave port | LSU access to 0x4000_2000 routes to m03 (GPIO) | test_gpio.c — GPIO_DIR write | tb_soc_top.sv — TC02: monitor m03_axi_arvalid handshake
8 | Axi4 Crossbar / Interconnect | XBAR_ADDR_DECODE_MBIST | Internal to SoC | Full SoC Integration | Firmware (C) | Internal AXI4 Crossbar | Internal crossbar address decoder routes core LSU transaction to MBIST slave port | LSU access to 0x4000_3000 routes to m04 (MBIST CSR) | test_mbist.c — MBIST_START write | tb_soc_top.sv — monitor m04_axi_awaddr == 0x4000_3000
9 | Axi4 Crossbar / Interconnect | XBAR_ADDR_DECODE_ECC | Internal to SoC | Full SoC Integration | Firmware (C) | Internal AXI4 Crossbar | Internal crossbar address decoder routes core LSU transaction to ECC slave port | LSU access to 0x4000_4000 routes to m05 (ECC Monitor) | test_ecc.c — ECC_ENABLE write | tb_soc_top.sv — monitor m05_axi_awvalid
10 | Axi4 Crossbar / Interconnect | XBAR_ADDR_DECODE_WDT | Internal to SoC | Full SoC Integration | Firmware (C) | Internal AXI4 Crossbar | Internal crossbar address decoder routes core LSU transaction to WDT slave port | LSU access to 0x4000_5000 routes to m06 (WDT) | test_watchdog.c — WDG_ENABLE write | tb_soc_top.sv — monitor m06_axi_awvalid
11 | Axi4 Crossbar / Interconnect | XBAR_DECERR_UNMAPPED | Internal to SoC | Full SoC Integration | Firmware (C) | Internal AXI4 Crossbar | Internal address decoder generates DECERR on unmapped addresses without hanging CPU | LSU access to unmapped address (e.g. 0xDEAD_0000) returns DECERR from crossbar — core must survive | Implicit — firmware accesses unmapped offset in SLVERR subtests | tb_soc_top.sv — TC02: monitor any mXX_rresp == 2b11 (DECERR)
12 | Axi4 Crossbar / Interconnect | XBAR_64TO32_BRIDGE | Internal to SoC | Standalone Unit TB | Firmware (C) / Bridge | Internal AXI4 Crossbar | Internal 64-bit to 32-bit protocol downconversion bridge between LSU and peripheral bus | AXI4 64-bit LSU write correctly downconverted to 32-bit by axi4_to_axil_bridge before reaching peripheral register | test_gpio.c — GPIO_OUT = 0xA5 (32-bit value visible on 64-bit bus) | tb_axil_gpio_top.v — verify wdata[31:0] matches written value after bridge
13 | Axi4 Crossbar / Interconnect | XBAR_CONCURRENT_MASTERS | Internal to SoC | Full SoC Integration | Firmware (C) + IFU/LSU | Internal AXI4 Crossbar | Internal crossbar concurrent arbitration between IFU fetch and LSU write transactions | IFU fetch (m00/ICCM) and LSU peripheral write (m01-m06) occur simultaneously without arbitration deadlock | Any firmware test — IFU always active while LSU writes | tb_soc_top.sv — monitor ifu_axi_arvalid and lsu_axi_awvalid high in same cycle
14 | Uart | UART_RESET_STATE | Internal to SoC | Standalone Unit TB | Firmware (C) / AXI BFM | Internal UART CSRs & FIFO | Internal UART register configuration, TX FIFO buffering, and SLVERR error handling | LSR[5] THRE=1 and LSR[6] TEMT=1 at cold boot (TX FIFO and shift register empty) | test_uart.c — Subtest 1: read LSR at boot | tb_axil_uart_top.v — check LSR reset value
15 | Uart | UART_LCR_8N1 | Internal to SoC | Standalone Unit TB | Firmware (C) / AXI BFM | Internal UART CSRs & FIFO | Internal UART register configuration, TX FIFO buffering, and SLVERR error handling | LCR=0x03 programs 8 data bits / no parity / 1 stop bit; readback matches | test_uart.c — Subtest 2: write 0x03 read back | tb_axil_uart_top.v — verify LCR register stores value
16 | Uart | UART_LCR_PARITY | External to SoC | Standalone Unit TB | Firmware (C) + TB Pin Monitor | External Serial Pin (uart_tx_o) | Serial parity bit verified externally on SoC output pin uart_tx_o | LCR parity bits (odd/even) write and readback correctly | test_uart.c — Subtest 2: 0x0B (8O1) / 0x1B (8E1) | tb_axil_uart_top.v — verify parity encoding on TX serial output
17 | Uart | UART_BAUD_DLAB | Internal to SoC | Standalone Unit TB | Firmware (C) / AXI BFM | Internal UART CSRs & FIFO | Internal UART register configuration, TX FIFO buffering, and SLVERR error handling | LCR[7]=1 enables DLAB; BAUD_DIV register write/readback at 0x4000_0008 | test_uart.c — Subtest 3: LCR=0x83 then write/read UART_BDIV | tb_axil_uart_top.v — verify baud divisor register path
18 | Uart | UART_TX_THRE_POLL | External to SoC | Standalone Unit TB | Firmware (C) + TB Pin Monitor | External Serial Pin (uart_tx_o) | Transmitted serial bitstream snooped externally on SoC output pin uart_tx_o | Firmware writes THR only when LSR[5]=1 (THRE); no data loss under polling | test_uart.c — Subtest 5: send A-Z with explicit THRE poll | tb_axil_uart_top.v — verify each byte appears on uart_tx_o serial output
19 | Uart | UART_TX_FIFO_DEPTH | Internal to SoC | Standalone Unit TB | Firmware (C) / AXI BFM | Internal UART CSRs & FIFO | Internal UART register configuration, TX FIFO buffering, and SLVERR error handling | TX FIFO holds 16 entries; firmware can burst 16 bytes without THRE stalling | test_uart.c — Subtest 6: three-line burst | tb_axil_uart_top.v — verify no byte dropped during burst
20 | Uart | UART_TEMT_DRAIN | External to SoC | Standalone Unit TB | Firmware (C) + TB Pin Monitor | External Serial Pin (uart_tx_o) | TX shift register serial draining verified on external uart_tx_o pin | LSR[6] TEMT asserts only after both TX FIFO and TX shift register drain | test_uart.c — Subtest 7: wait_temt() after burst | tb_axil_uart_top.v — monitor TEMT high after last serial bit
21 | Uart | UART_IER_RW | Internal to SoC | Standalone Unit TB | Firmware (C) / AXI BFM | Internal UART CSRs & FIFO | Internal UART register configuration, TX FIFO buffering, and SLVERR error handling | IER bits 0 and 1 write/readback independently; clear to 0 disables all interrupts | test_uart.c — Subtest 4: IER=0x01 / 0x02 / 0x03 / 0x00 | tb_axil_uart_top.v — verify IER register behaviour
22 | Uart | UART_SLVERR_UNMAPPED | Internal to SoC | Standalone Unit TB | Firmware (C) / AXI BFM | Internal UART CSRs & FIFO | Internal UART register configuration, TX FIFO buffering, and SLVERR error handling | Read from UART+0x010 (reserved offset) returns SLVERR; CPU continues executing | test_uart.c — Subtest 8: read from UART_BASE+0x010 | tb_axil_uart_top.v — verify SLVERR response on unmapped offset
23 | Gpio | GPIO_RESET_STATE | Internal to SoC | Standalone Unit TB | Firmware (C) / AXI BFM | Internal GPIO CSRs | Internal GPIO register read/write, output retention, and SLVERR response | GPIO_DIR=0x00 (all inputs) and GPIO_OUT=0x00 after reset | test_gpio.c — Subtest 1: read DIR and OUT at boot | tb_axil_gpio_top.v — verify reset values of both registers
24 | Gpio | GPIO_DIR_WALKING_ONES | External to SoC | Standalone Unit TB | Firmware (C) + TB Pin Monitor | External I/O Pins (gpio_out_o) | Pin-level output drive and direction gating verified at SoC external gpio_out_o boundary | Each individual GPIO_DIR bit can be set to 1 independently (8 iterations) | test_gpio.c — Subtest 2: walking-ones loop | tb_axil_gpio_top.v — verify gpio_out_o gating per bit
25 | Gpio | GPIO_DIR_WALKING_ZEROS | External to SoC | Standalone Unit TB | Firmware (C) + TB Pin Monitor | External I/O Pins (gpio_out_o) | Pin-level output drive and direction gating verified at SoC external gpio_out_o boundary | Each individual GPIO_DIR bit can be cleared to 0 independently | test_gpio.c — Subtest 2: walking-zeros loop | tb_axil_gpio_top.v — verify gpio_out_o gating per bit
26 | Gpio | GPIO_OUT_CHECKERBOARD | External to SoC | Standalone Unit TB | Firmware (C) + TB Pin Monitor | External I/O Pins (gpio_out_o) | Pin-level output drive and direction gating verified at SoC external gpio_out_o boundary | GPIO_OUT=0xA5 and GPIO_OUT=0x5A write/readback correctly | test_gpio.c — Subtest 3: 0xA5 / 0x5A patterns | tb_axil_gpio_top.v — verify gpio_out_o == DIR & OUT
27 | Gpio | GPIO_OUT_DIR_INDEPENDENCE | Internal to SoC | Standalone Unit TB | Firmware (C) / AXI BFM | Internal GPIO CSRs | Internal GPIO register read/write, output retention, and SLVERR response | GPIO_OUT retains value across GPIO_DIR changes (DIR does not corrupt OUT register) | test_gpio.c — Subtest 4: set OUT=0xC3 then flip DIR multiple times | tb_axil_gpio_top.v — verify gpio_out_o changes but OUT register constant
28 | Gpio | GPIO_IN_READONLY | Internal to SoC | Standalone Unit TB | Firmware (C) / AXI BFM | Internal GPIO CSRs | Internal GPIO register read/write, output retention, and SLVERR response | Writes to GPIO_IN offset are silently ignored; register value unchanged | test_gpio.c — Subtest 5: write ~before to GPIO_IN; readback unchanged | tb_axil_gpio_top.v — force gpio_in_i; verify write to 0x008 has no effect
29 | Gpio | GPIO_OUTPUT_GATING | External to SoC | Standalone Unit TB | Firmware (C) + TB Pin Monitor | External I/O Pins (gpio_out_o) | Pin-level output drive and direction gating verified at SoC external gpio_out_o boundary | gpio_out_o[i] = gpio_dir[i] AND gpio_out_reg[i] — hardware gating verified | test_gpio.c — Subtest 6: DIR=0x0F OUT=0xFF; expected gpio_out_o=0x0F | tb_axil_gpio_top.v — check gpio_out_o against expected mask
30 | Gpio | GPIO_INPUT_SYNC | External to SoC | Standalone Unit TB | External TB Stimulus | External I/O Pin (gpio_in_i) | TB drives external gpio_in_i pin to verify internal 2-flop input synchronizer | gpio_in_i external value appears in GPIO_IN after 2-flop synchronisation | Not applicable (requires TB to drive gpio_in_i) | tb_axil_gpio_top.v — force gpio_in_i; read GPIO_IN after 2 clock edges
31 | Gpio | GPIO_SLVERR_UNMAPPED | Internal to SoC | Standalone Unit TB | Firmware (C) / AXI BFM | Internal GPIO CSRs | Internal GPIO register read/write, output retention, and SLVERR response | Read from GPIO+0x00C (unmapped) returns SLVERR; CPU survives | test_gpio.c — Subtest 7: read from GPIO_BASE+0x00C | tb_axil_gpio_top.v — verify SLVERR on unmapped GPIO offset
32 | System Timer | TIMER_RESET_STATE | Internal to SoC | Standalone Unit TB | Firmware (C) / AXI BFM | Internal Timer & Sideband | Internal timer reload, down-counting, hold-on-disable, and rollover logic | TMR_EN=0 / TMR_RELOAD=0 / TMR_COUNT=0 at cold boot | test_timer.c — Subtest 1: read all three registers at boot | tb_axil_systimer_top.v — verify reset values
33 | System Timer | TIMER_RELOAD_RW | Internal to SoC | Standalone Unit TB | Firmware (C) / AXI BFM | Internal Timer & Sideband | Internal timer reload, down-counting, hold-on-disable, and rollover logic | TMR_RELOAD accepts full 32-bit values including 0xDEADBEEF and 0xFFFFFFFF | test_timer.c — Subtest 2: multiple reload values | tb_axil_systimer_top.v — verify register storage
34 | System Timer | TIMER_COUNTDOWN | Internal to SoC | Standalone Unit TB | Firmware (C) / AXI BFM | Internal Timer & Sideband | Internal timer reload, down-counting, hold-on-disable, and rollover logic | TMR_COUNT decrements every clock cycle while TMR_EN=1; two reads show strictly decreasing value | test_timer.c — Subtest 3: c1 then delay then c2; assert c2 < c1 | tb_axil_systimer_top.v — monitor timer_count decrement
35 | System Timer | TIMER_HOLD_ON_DISABLE | Internal to SoC | Standalone Unit TB | Firmware (C) / AXI BFM | Internal Timer & Sideband | Internal timer reload, down-counting, hold-on-disable, and rollover logic | TMR_COUNT freezes (holds) when TMR_EN=0; re-enable resumes from frozen value | test_timer.c — Subtest 4: read h1/h2 while disabled; assert h1==h2 | tb_axil_systimer_top.v — verify count stops on disable
36 | System Timer | TIMER_REARM | Internal to SoC | Standalone Unit TB | Firmware (C) / AXI BFM | Internal Timer & Sideband | Internal timer reload, down-counting, hold-on-disable, and rollover logic | Disable then write TMR_RELOAD then re-enable: count preloads to TMR_RELOAD value (not frozen value) | test_timer.c — Subtest 5: partially drain; re-arm with new_reload; verify count==new_reload | tb_axil_systimer_top.v — verify re-arm preloads reload value
37 | System Timer | TIMER_COUNT_READONLY | Internal to SoC | Standalone Unit TB | Firmware (C) / AXI BFM | Internal Timer & Sideband | Internal timer reload, down-counting, hold-on-disable, and rollover logic | Writes to TMR_COUNT (0x008) are silently accepted (OKAY) but counter is unaffected | test_timer.c — Subtest 6: write 0xDEADBEEF to TMR_COUNT; readback unchanged | tb_axil_systimer_top.v — verify write to RO register has no effect
38 | System Timer | TIMER_TICK_PULSE | Internal to SoC | Standalone Unit TB | Internal HW Pulse | Internal Timer & Sideband | Internal timer_tick_o hardware pulse auto-triggers MBIST scan via on-chip sideband | timer_tick_o pulses HIGH for exactly 1 clock cycle on countdown expiry; counter auto-reloads | Not applicable (requires cycle-accurate measurement) | tb_axil_systimer_top.v — monitor timer_tick_o width == 1 cycle
39 | System Timer | TIMER_TICK_MBIST_TRIGGER | Internal to SoC | Full SoC Integration | Internal HW Pulse | Internal Timer & Sideband | Internal timer_tick_o hardware pulse auto-triggers MBIST scan via on-chip sideband | timer_tick_o connected to MBIST Controller timer_tick_i; MBIST auto-starts on tick | Not applicable (SoC-level wiring) | tb_soc_top.sv — TC07: pulse timer_tick; verify mbist_active asserts within 20 cycles
40 | System Timer | TIMER_SLVERR_UNMAPPED | Internal to SoC | Standalone Unit TB | Firmware (C) / AXI BFM | Internal Timer & Sideband | Internal timer reload, down-counting, hold-on-disable, and rollover logic | Read from Timer+0x00C (unmapped) returns SLVERR; CPU survives | test_timer.c — Subtest 8: read from TMR_BASE+0x00C | tb_axil_systimer_top.v — verify SLVERR response
41 | Watchdog Timer | WDT_RESET_STATE | Internal to SoC | Standalone Unit TB | Firmware (C) / AXI BFM | Internal WDT CSRs & Logic | Internal watchdog counter, reload, kick servicing, and pretimeout interrupt threshold | WDG_ENABLE=0 at cold boot; WDT not running; no spurious timeout | test_watchdog.c — Subtest 1: read WDG_ENABLE at boot | tb_axil_wdt_top.v — verify no wdg_timeout_o pulse at reset
42 | Watchdog Timer | WDT_LOAD_RW | Internal to SoC | Standalone Unit TB | Firmware (C) / AXI BFM | Internal WDT CSRs & Logic | Internal watchdog counter, reload, kick servicing, and pretimeout interrupt threshold | WDG_LOAD accepts full 32-bit values including boundary cases | test_watchdog.c — Subtest 2: multiple load values | tb_axil_wdt_top.v — verify register storage
43 | Watchdog Timer | WDT_COUNTDOWN | Internal to SoC | Standalone Unit TB | Firmware (C) / AXI BFM | Internal WDT CSRs & Logic | Internal watchdog counter, reload, kick servicing, and pretimeout interrupt threshold | WDG_COUNT decrements each clock cycle while WDG_ENABLE=1 | test_watchdog.c — Subtest 3: enable; read c1/c2; assert c2 < c1 | tb_axil_wdt_top.v — monitor wdg_count decrement
44 | Watchdog Timer | WDT_KICK_RELOADS | Internal to SoC | Standalone Unit TB | Firmware (C) / AXI BFM | Internal WDT CSRs & Logic | Internal watchdog counter, reload, kick servicing, and pretimeout interrupt threshold | Writing WDG_KICK reloads WDG_COUNT to WDG_LOAD instantly | test_watchdog.c — Subtest 4: enable; drain; kick; assert count==WDG_LOAD | tb_axil_wdt_top.v — verify count restores to load value on kick
45 | Watchdog Timer | WDT_HOLD_ON_DISABLE | Internal to SoC | Standalone Unit TB | Firmware (C) / AXI BFM | Internal WDT CSRs & Logic | Internal watchdog counter, reload, kick servicing, and pretimeout interrupt threshold | WDG_COUNT holds at current value when WDG_ENABLE=0 (does NOT reset to load) | test_watchdog.c — Subtest 5: disable; read h1/h2; assert h1==h2 and h1!=WDG_LOAD | tb_axil_wdt_top.v — verify count freezes on disable
46 | Watchdog Timer | WDT_STATUS_W1C | Internal to SoC | Standalone Unit TB | Firmware (C) / AXI BFM | Internal WDT CSRs & Logic | Internal watchdog counter, reload, kick servicing, and pretimeout interrupt threshold | WDG_STATUS[0] timeout_occurred cleared by writing 1; writing 0 has no effect | test_watchdog.c — Subtest 6: write 1 clears; write 0 leaves unchanged | tb_axil_wdt_top.v — verify W1C behaviour
47 | Watchdog Timer | WDT_STATUS_STICKY | External to SoC | Standalone Unit TB | External TB Reset Toggle | External Reset Pins | Requires TB toggling warm reset (axi_aresetn) vs cold reset (por_rstn) to verify sticky bit | timeout_occurred survives warm system reset (axi_aresetn) but clears on POR (por_rstn) | Not applicable (warm reset kills firmware) | tb_axil_wdt_top.v — assert axi_aresetn; verify status bit survives; assert por_rstn; verify clears
48 | Watchdog Timer | WDT_PRETIMEOUT_RW | Internal to SoC | Standalone Unit TB | Firmware (C) / AXI BFM | Internal WDT CSRs & Logic | Internal watchdog counter, reload, kick servicing, and pretimeout interrupt threshold | WDG_PRETIMEOUT register write/readback with threshold < WDG_LOAD | test_watchdog.c — Subtest 7: multiple pretimeout values | tb_axil_wdt_top.v — verify pretimeout_irq_o asserts when count <= threshold
49 | Watchdog Timer | WDT_PRETIMEOUT_IRQ | Internal to SoC | Standalone Unit TB | Firmware (C) / AXI BFM | Internal WDT CSRs & Logic | Internal watchdog counter, reload, kick servicing, and pretimeout interrupt threshold | pretimeout_irq_o asserts when WDG_COUNT falls below WDG_PRETIMEOUT threshold | Not applicable (interrupt timing requires cycle precision) | tb_axil_wdt_top.v — count down to threshold; verify pretimeout_irq_o rises
50 | Watchdog Timer | WDT_TIMEOUT_RESET | External to SoC | Standalone Unit TB | Internal WDT + External Pin | External Reset Pin (wdg_timeout_o) | wdg_timeout_o asserts on external pin to drive external board-level reset controller | WDG_COUNT reaching 0 asserts wdg_timeout_o which drives system reset | Not applicable (timeout kills firmware) | tb_axil_wdt_top.v — load small value; enable; count to 0; verify wdg_timeout_o pulse
51 | Watchdog Timer | WDT_NO_TIMEOUT_DURING_TEST | Internal to SoC | Full SoC Integration | Firmware (C) / AXI BFM | Internal WDT CSRs & Logic | Internal watchdog counter, reload, kick servicing, and pretimeout interrupt threshold | WDG_STATUS[0] remains 0 throughout all subtests (no accidental expiry) | test_watchdog.c — Subtest 8: final status check | tb_soc_top.sv — verify no wdg_timeout_o assertion during full test
52 | Watchdog Timer | WDT_PRETIMEOUT_PIC_ROUTING | Internal to SoC | Full SoC Integration | Internal IRQ Line | Internal PIC Interrupt | Pretimeout interrupt line routed internally from WDT to VeeR PIC extintsrc_req[2] | wdg_irq_pretimeout_o routed to PIC extintsrc_req[2]; no bus errors after IRQ | Not applicable | tb_soc_top.sv — TC06: pulse wdg_irq_pretimeout; verify no double-ECC error
53 | Mbist Controller | MBIST_CSR_READBACK | Internal to SoC | Standalone Unit TB | Firmware (C) / MBIST HW | Internal MBIST CSRs & BIST Engine | Internal BIST engine executing autonomous Checkerboard / March C- memory verification | All CSR registers (ALGO_SEL / ADDR_START / ADDR_END) write and readback correctly before scan | test_mbist.c — Subtest 1: write/read each register | tb_axil_mbist_ctrl_top.v — verify all 9 register values via BFM
54 | Mbist Controller | MBIST_BUSY_DONE_HANDSHAKE | Internal to SoC | Standalone Unit TB | Firmware (C) / MBIST HW | Internal MBIST CSRs & BIST Engine | Internal BIST engine executing autonomous Checkerboard / March C- memory verification | mbist_busy asserts immediately after MBIST_START write; mbist_done asserts on completion | test_mbist.c — Subtest 2: read busy after start; poll done | tb_axil_mbist_ctrl_top.v — verify busy/done timing in waveform
55 | Mbist Controller | MBIST_DONE_W1C | Internal to SoC | Standalone Unit TB | Firmware (C) / MBIST HW | Internal MBIST CSRs & BIST Engine | Internal BIST engine executing autonomous Checkerboard / March C- memory verification | mbist_done cleared by writing 1 (W1C); stays asserted if write 0 | test_mbist.c — Subtest 3: write 1 to MBIST_DONE; verify cleared | tb_axil_mbist_ctrl_top.v — verify W1C behaviour
56 | Mbist Controller | MBIST_CHECKERBOARD_SMALL | Internal to SoC | Standalone Unit TB | Firmware (C) / MBIST HW | Internal MBIST CSRs & BIST Engine | Internal BIST engine executing autonomous Checkerboard / March C- memory verification | Checkerboard algorithm on 128-byte DCCM window completes with PASS (pass_fail=0) | test_mbist.c — Subtest 2: ALGO=CB MB_START to MB_SM_END | tb_axil_mbist_ctrl_top.v — inject no fault; verify pass_fail==0
57 | Mbist Controller | MBIST_MARCH_C_SMALL | Internal to SoC | Standalone Unit TB | Firmware (C) / MBIST HW | Internal MBIST CSRs & BIST Engine | Internal BIST engine executing autonomous Checkerboard / March C- memory verification | March C- algorithm on 128-byte window completes with PASS | test_mbist.c — Subtest 4: ALGO=MC MB_START to MB_SM_END | tb_axil_mbist_ctrl_top.v — verify pass_fail==0 and fault_count==0
58 | Mbist Controller | MBIST_MARCH_C_FULL | Internal to SoC | Standalone Unit TB | Firmware (C) / MBIST HW | Internal MBIST CSRs & BIST Engine | Internal BIST engine executing autonomous Checkerboard / March C- memory verification | March C- over full safe DCCM scan window (MB_START to MB_END = 8 KB) completes with PASS | test_mbist.c — Subtest 5: ALGO=MC MB_START to MB_END | tb_axil_mbist_ctrl_top.v — full range scan; verify pass_fail==0
59 | Mbist Controller | MBIST_FAULT_DOUBLE_BIT | External to SoC | Full SoC & Standalone TB | External TB Fault Injection | External Memory Fault Hook | TB injects double-bit fault into DCCM behavioral model to verify MBIST fault capture | Double-bit DCCM fault causes SLVERR on DMA read; pass_fail=1; fault_addr captured | Not applicable (fault injection is TB-side) | tb_axil_mbist_ctrl_top.v + tb_soc_top.sv TC04 — inject double-bit; verify pass_fail==1 and fault_count>0
60 | Mbist Controller | MBIST_FAULT_ADDR_CAPTURE | External to SoC | Standalone Unit TB | External TB Fault Injection | External Memory Fault Hook | TB injects double-bit fault into DCCM behavioral model to verify MBIST fault capture | mbist_fault_addr holds address of first fault; mbist_fault_count increments per fault | Not applicable | tb_axil_mbist_ctrl_top.v — inject fault at known address; verify fault_addr matches
61 | Mbist Controller | MBIST_DMA_AXI4_MASTER | Internal to SoC | Standalone Unit TB | Internal MBIST HW Engine | Internal DMA & Interconnect | Internal 64-bit AXI4 DMA master, sideband throttling, and interrupt generation | MBIST DMA master issues correct 64-bit AXI4 transactions to DCCM DMA Slave Port | Not applicable | tb_axil_mbist_ctrl_top.v — monitor AXI4 DMA master signals during scan
62 | Mbist Controller | MBIST_TIMER_AUTOTRIGGER | Internal to SoC | Full SoC Integration | Internal MBIST HW Engine | Internal DMA & Interconnect | Internal 64-bit AXI4 DMA master, sideband throttling, and interrupt generation | timer_tick_i input starts MBIST scan without firmware MBIST_START write | Not applicable | tb_soc_top.sv — TC07: pulse timer_tick; mbist_active within 20 cycles
63 | Mbist Controller | MBIST_ACTIVE_SIDEBAND | Internal to SoC | Full SoC Integration | Internal MBIST HW Engine | Internal DMA & Interconnect | Internal 64-bit AXI4 DMA master, sideband throttling, and interrupt generation | mbist_active_o asserts during scan and deasserts on completion | Not applicable | tb_soc_top.sv — monitor mbist_active rising/falling edge around scan
64 | Mbist Controller | MBIST_IRQ_DONE | Internal to SoC | Full SoC Integration | Internal MBIST HW Engine | Internal DMA & Interconnect | Internal 64-bit AXI4 DMA master, sideband throttling, and interrupt generation | mbist_irq_done_o pulses 1 cycle on scan completion; routed to PIC extintsrc_req[1] | Not applicable | tb_soc_top.sv — TC03: monitor mbist_irq_done after scan completes
65 | Mbist Controller | MBIST_SCAN_WINDOW | Internal to SoC | Standalone Unit TB | Internal MBIST HW Engine | Internal DMA & Interconnect | Internal 64-bit AXI4 DMA master, sideband throttling, and interrupt generation | Only addresses between mbist_addr_start and mbist_addr_end are accessed — nothing outside | Not applicable | tb_axil_mbist_ctrl_top.v — monitor DMA AXI araddr stays within configured window
66 | Ecc Monitor | ECC_MON_SHADOW_RW | Internal to SoC | Standalone Unit TB | Firmware (C) / AXI BFM | Internal ECC Monitor CSRs | Internal ECC monitor shadow registers, correlation flag, and suspect address capture | ecc_mon_shadow_count (27-bit) and ecc_mon_shadow_thresh (5-bit) write/readback correctly | test_ecc.c — Subtest 1: write 0x1234 / 5 to shadow regs | tb_axil_ecc_monitor_top.v — verify register storage and bit-width masking
67 | Ecc Monitor | ECC_MON_DISABLED_SUPPRESSION | Internal to SoC | Standalone Unit TB | Firmware (C) / AXI BFM | Internal ECC Monitor CSRs | Internal ECC monitor shadow registers, correlation flag, and suspect address capture | ecc_mon_event write ignored when ecc_mon_enable=0; status unchanged | test_ecc.c — Subtest 2: disable monitor; fire event; verify status==0 | tb_axil_ecc_monitor_top.v — verify no status change when disabled
68 | Ecc Monitor | ECC_MON_CORRECTABLE_SEEN | Internal to SoC | Standalone Unit TB | Firmware (C) / AXI BFM | Internal ECC Monitor CSRs | Internal ECC monitor shadow registers, correlation flag, and suspect address capture | correctable_seen flag (status[0]) sets when ecc_mon_event written with monitor enabled | test_ecc.c — Subtest 3: enable; write event; verify status[0]==1 | tb_axil_ecc_monitor_top.v — verify status bit assertion
69 | Ecc Monitor | ECC_MON_IDLE_NOT_CORRELATED | Internal to SoC | Standalone Unit TB | Firmware (C) / AXI BFM | Internal ECC Monitor CSRs | Internal ECC monitor shadow registers, correlation flag, and suspect address capture | mbist_correlated flag (status[1]) stays 0 when event fires but no MBIST scan is active | test_ecc.c — Subtest 3: verify status[1]==0 with no scan active | tb_axil_ecc_monitor_top.v — verify no false correlation
70 | Ecc Monitor | ECC_MON_MBIST_CORRELATED | Internal to SoC | Full SoC Integration | Firmware (C) / AXI BFM | Internal ECC Monitor CSRs | Internal ECC monitor shadow registers, correlation flag, and suspect address capture | mbist_correlated flag (status[1]) sets when ecc_mon_event fires during active MBIST scan | test_ecc.c — Subtest 4: start scan; wait busy; fire event; verify status[1]==1 | tb_soc_top.sv — TC05: inject single-bit fault; verify dccm_ecc_single_error + correlation
71 | Ecc Monitor | ECC_MON_SUSPECT_ADDR | Internal to SoC | Standalone Unit TB | Firmware (C) / AXI BFM | Internal ECC Monitor CSRs | Internal ECC monitor shadow registers, correlation flag, and suspect address capture | ecc_mon_suspect_addr captures MBIST scan window address at time of correlated event | test_ecc.c — Subtest 4: verify suspect_addr inside DCCM range | tb_axil_ecc_monitor_top.v — verify suspect_addr falls within mbist window
72 | Ecc Monitor | ECC_MON_EVENT_W1C | Internal to SoC | Standalone Unit TB | Firmware (C) / AXI BFM | Internal ECC Monitor CSRs | Internal ECC monitor shadow registers, correlation flag, and suspect address capture | ecc_mon_event reads back 0 after write (W1C register) | test_ecc.c — Subtest 5: verify ECC_EVENT reads 0 after write | tb_axil_ecc_monitor_top.v — verify W1C behaviour
73 | Ecc Monitor | ECC_DCCM_SINGLE_BIT | External to SoC | Full SoC Integration | External TB Fault Injection | External Memory Fault Hook | TB injects 1-bit or 2-bit error into DCCM/ICCM model to verify VeeR core SECDED hardware | VeeR EL2 SECDED hardware corrects 1-bit DCCM error inline; dccm_ecc_single_error_o asserts; mdccmect increments | Not applicable (fault injection TB-side) | tb_soc_top.sv — TC05: inject 1-bit via u_dccm.inject_single_bit_fault; monitor dccm_ecc_single_error_o
74 | Ecc Monitor | ECC_DCCM_DOUBLE_BIT | External to SoC | Full SoC Integration | External TB Fault Injection | External Memory Fault Hook | TB injects 1-bit or 2-bit error into DCCM/ICCM model to verify VeeR core SECDED hardware | VeeR EL2 SECDED detects 2-bit DCCM error; RRESP=SLVERR returned; dccm_ecc_double_error_o asserts | Not applicable | tb_soc_top.sv — TC04: inject 2-bit; verify dccm_ecc_double_error_o and SLVERR
75 | Ecc Monitor | ECC_ICCM_SINGLE_BIT | External to SoC | Full SoC Integration | External TB Fault Injection | External Memory Fault Hook | TB injects 1-bit or 2-bit error into DCCM/ICCM model to verify VeeR core SECDED hardware | VeeR EL2 corrects 1-bit ICCM error inline; iccm_ecc_single_error_o asserts | Not applicable | tb_soc_top.sv — inject 1-bit into u_iccm; monitor iccm_ecc_single_error_o
76 | Interrupt System | IRQ_MBIST_DONE_PIC | Internal to SoC | Full SoC Integration | Internal PIC Hardware | Internal PIC & IRQ Lines | Internal interrupt routing from custom IPs to PIC and priority arbitration in core | mbist_irq_done_o routed to extintsrc_req[1] and reaches PIC; firmware ISR executes | test_mbist.c — Requires ISR handler (future firmware) | tb_soc_top.sv — TC08: wait for UART PASS token after MBIST IRQ
77 | Interrupt System | IRQ_WDT_PRETIMEOUT_PIC | Internal to SoC | Full SoC Integration | Internal PIC Hardware | Internal PIC & IRQ Lines | Internal interrupt routing from custom IPs to PIC and priority arbitration in core | wdg_irq_pretimeout_o routed to extintsrc_req[2] and reaches PIC; no bus faults ensue | test_watchdog.c — Requires ISR handler (future firmware) | tb_soc_top.sv — TC06: pulse pretimeout; verify no double-ECC after IRQ
78 | Interrupt System | IRQ_PIC_PRIORITY | Internal to SoC | Full SoC Integration | Internal PIC Hardware | Internal PIC & IRQ Lines | Internal interrupt routing from custom IPs to PIC and priority arbitration in core | PIC correctly prioritises MBIST IRQ (extintsrc_req[1]) over WDT IRQ (extintsrc_req[2]) when both asserted simultaneously | Not applicable | tb_soc_top.sv — assert both simultaneously; verify higher-priority IRQ taken first
79 | Dccm Ecc Architecture | DCCM_WRITE_READBACK | Internal to SoC | Full SoC Integration | Firmware (C) / Core SECDED | Internal DCCM & SECDED Logic | VeeR EL2 core internal SECDED ECC encode on write and decode/correction on read | VeeR EL2 LSU writes a pattern to DCCM and reads it back correctly; write-readback error flag stays 0 | test_mbist.c — DCCM written by MBIST DMA; LSU reads back | tb_soc_top.sv — monitor dccm_write_readback_error_o stays 0
80 | Dccm Ecc Architecture | DCCM_ECC_ENCODE_DECODE | Internal to SoC | Full SoC Integration | Firmware (C) / Core SECDED | Internal DCCM & SECDED Logic | VeeR EL2 core internal SECDED ECC encode on write and decode/correction on read | VeeR EL2 core encodes SECDED ECC on every DCCM write and decodes on every read — no spurious errors on clean memory | Not applicable | tb_soc_top.sv + dccm_behavioral_model.v — run full scan with no faults; verify no ECC errors
81 | Dccm Ecc Architecture | DCCM_MBIST_INDIRECT_SINGLE | External to SoC | Full SoC Integration | External TB Fault Injection | External Memory Fault Hook | TB injects 1-bit fault into DCCM to verify inline correction and shadow counter correlation | Single-bit fault not detected by MBIST data mismatch (corrected inline) — inferred via mdccmect rise + ECC Monitor correlation | test_ecc.c — mdccmect shadow comparison + ECC event | tb_soc_top.sv — inject 1-bit; verify pass_fail stays 0 but dccm_ecc_single_error asserts
82 | Full Soc Integration | SOC_FIRMWARE_BOOT_TO_PASS | Internal to SoC | Full SoC Integration | Firmware (C on VeeR Core) | Full SoC Subsystem Integration | End-to-end in-system execution of bare-metal firmware running on the internal RISC-V CPU | Full firmware test (test_mbist.c) boots executes and prints ALL TESTS PASSED on UART within timeout | test_mbist.c — all 5 subtests pass; uart_print(ALL TESTS PASSED) | tb_soc_top.sv — TC08: monitor uart_pass_seen within 2M cycles
83 | Full Soc Integration | SOC_CONCURRENT_IFU_LSU | Internal to SoC | Full SoC Integration | Firmware (C on VeeR Core) | Full SoC Subsystem Integration | End-to-end in-system execution of bare-metal firmware running on the internal RISC-V CPU | IFU instruction fetch (ICCM) and LSU peripheral write (peripherals) proceed simultaneously without stall or corruption | Any firmware test — IFU always active | tb_soc_top.sv — monitor ifu_axi_arvalid and lsu_axi_awvalid simultaneously high
84 | Full Soc Integration | SOC_MBIST_WHILE_CPU_RUNNING | Internal to SoC | Full SoC Integration | Firmware (C on VeeR Core) | Full SoC Subsystem Integration | End-to-end in-system execution of bare-metal firmware running on the internal RISC-V CPU | MBIST DMA master accesses DCCM via DMA Slave Port while CPU executes from ICCM — no interference | test_mbist.c — CPU polls MBIST_DONE while MBIST scans DCCM | tb_soc_top.sv — monitor mbist_active=1 and ifu_axi_arvalid=1 simultaneously
85 | Full Soc Integration | SOC_FULL_PERIPHERAL_SCAN | Internal to SoC | Full SoC Integration | Firmware (C on VeeR Core) | Full SoC Subsystem Integration | End-to-end in-system execution of bare-metal firmware running on the internal RISC-V CPU | All 6 peripherals accessed in sequence within one firmware run; all return OKAY; no bus hangs | Covered collectively by test_mbist + test_ecc + test_uart + test_gpio + test_timer + test_watchdog | tb_soc_top.sv — run all firmware tests sequentially; no timeout on any mXX bus
