Rohit1050/SoC-Memory-MBIST-RISCV/scripts/ecc_status_vip/ecc_status_uvm_tb/ecc_status_item.sv

class ecc_status_item extends uvm_sequence_item;

  bit dccm_ecc_single_error_o;
  bit dccm_ecc_double_error_o;
  bit iccm_ecc_single_error_o;
  bit iccm_ecc_double_error_o;

  `uvm_object_utils(ecc_status_item)

  function new(string name="ecc_status_item"); super.new(name); endfunction
endclass
