Rohit1050/SoC-Memory-MBIST-RISCV/scripts/ecc_status_vip/ecc_status_uvm_tb/ecc_status_pkg.sv

package ecc_status_pkg;
import uvm_pkg::*;
`include "uvm_macros.svh"
`include "ecc_status_item.sv"
`include "ecc_status_sequencer.sv"
`include "ecc_status_driver.sv"
`include "ecc_status_monitor.sv"
`include "ecc_status_agent.sv"
`include "ecc_status_scoreboard.sv"
`include "ecc_status_env.sv"
`include "ecc_status_test.sv"
endpackage
