Rohit1050/SoC-Memory-MBIST-RISCV/scripts/ecc_status_vip/ecc_status_uvm_tb/ecc_status_test.sv

class ecc_status_test extends uvm_test;
ecc_status_env env;
`uvm_component_utils(ecc_status_test)
function new(string n,uvm_component p);super.new(n,p);endfunction
function void build_phase(uvm_phase phase); env=ecc_status_env::type_id::create("env",this); endfunction
endclass
