Rohit1050/SoC-Memory-MBIST-RISCV/scripts/uart_vip/uart_uvm_tb/uart_agent.sv

class uart_agent extends uvm_agent;
uart_driver drv; uart_monitor mon; uart_sequencer seqr;
`uvm_component_utils(uart_agent)
function new(string n,uvm_component p);super.new(n,p);endfunction
function void build_phase(uvm_phase phase); drv=uart_driver::type_id::create("drv",this); mon=uart_monitor::type_id::create("mon",this); seqr=uart_sequencer::type_id::create("seqr",this); endfunction
function void connect_phase(uvm_phase phase); drv.seq_item_port.connect(seqr.seq_item_export); endfunction
endclass
