Rohit1050/SoC-Memory-MBIST-RISCV/scripts/wdt_timeout_vip/wdt_timeout_uvm_tb/wdt_timeout_pkg.sv

package wdt_timeout_pkg;
import uvm_pkg::*;
`include "uvm_macros.svh"
`include "wdt_timeout_item.sv"
`include "wdt_timeout_sequencer.sv"
`include "wdt_timeout_driver.sv"
`include "wdt_timeout_monitor.sv"
`include "wdt_timeout_agent.sv"
`include "wdt_timeout_scoreboard.sv"
`include "wdt_timeout_env.sv"
`include "wdt_timeout_test.sv"
endpackage
